mihnea-tirca/White-Cane/README.md

# White-Cane
Walking cane for the visually impaired project
