mihnea-tirca/White-Cane/Design.png

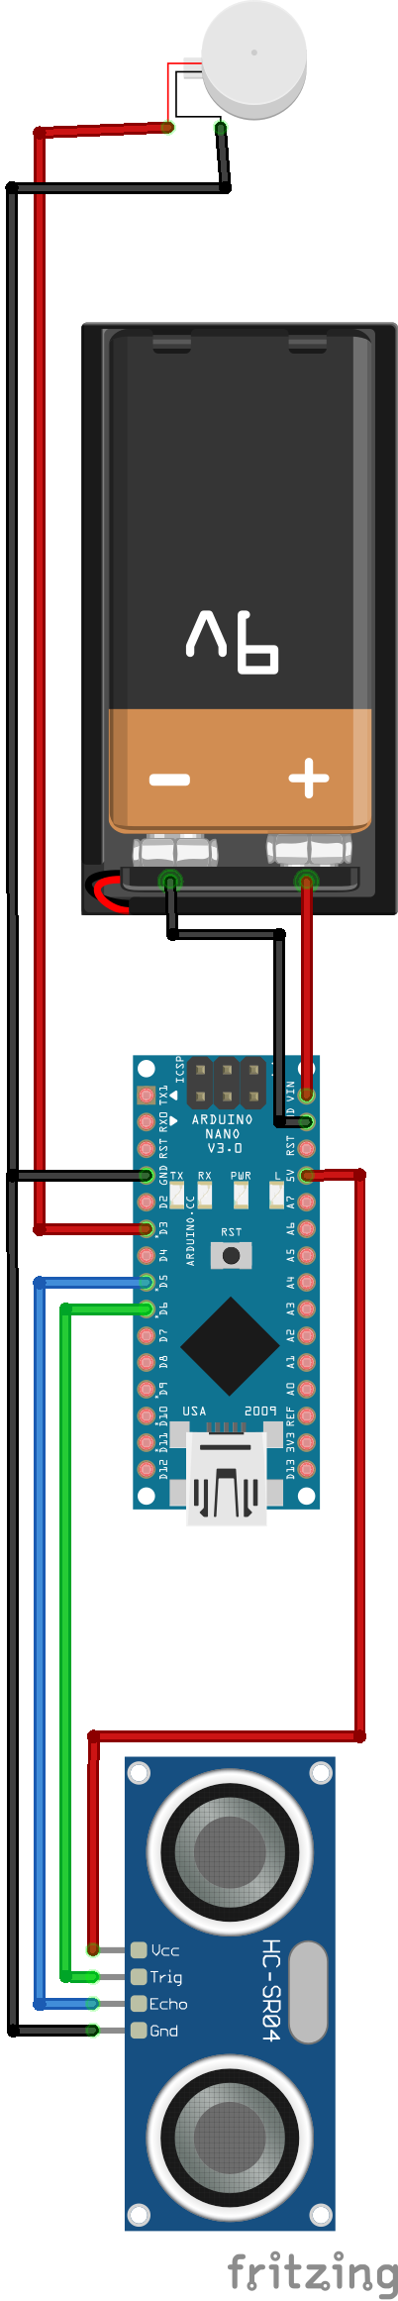
Design.png
